MohamedNasser-ASU/4Bit_Signed_ALU/simulation/README.md

# Simulation

This folder contains the Logisim Evolution simulation files for the 4-bit signed ALU project.

The simulation is used to test the ALU logic before or alongside the physical breadboard build. It includes the main ALU circuit and its subcircuits, such as ADD/SUB, comparator, absolute value logic, and multiplier.

Open the `.circ` file using Logisim Evolution to inspect, run, and test the circuit.

Screenshots of the simulation are stored separately in the `images/Logisim/` folder.
