MohamedNasser-ASU/4Bit_Signed_ALU/images/TinkerCAD/README.md

# TinkerCAD Circuit Screenshots

This directory contains screenshots of the TinkerCAD breadboard-style simulations for the 4-bit signed ALU project.

## Files

- `A&B_inputs.png`  
  Shows the DIP switch input section used to provide the 4-bit `A` and `B` values.

- `2's_complementer.png`  
  Shows the two's complement / absolute value circuit used for signed-number handling.

- `Adder_Subtractor.png`  
  Shows the ADD/SUB circuit, where `SUB = 0` performs addition and `SUB = 1` performs subtraction.

- `Comparator.png`  
  Shows the comparator section used to produce greater-than, equal, and less-than outputs.

- `Multiplier.png`  
  Shows the multiplier section used to generate the product output.

- `Full_ALU.png`  
  Shows the complete TinkerCAD ALU simulation with the main modules connected together.

## Note

These screenshots document the TinkerCAD simulation stage of the project before or alongside the physical breadboard implementation.
