MohamedNasser-ASU/4Bit_Signed_ALU/Documentation/Block diagrams/2sComplementer.jpeg

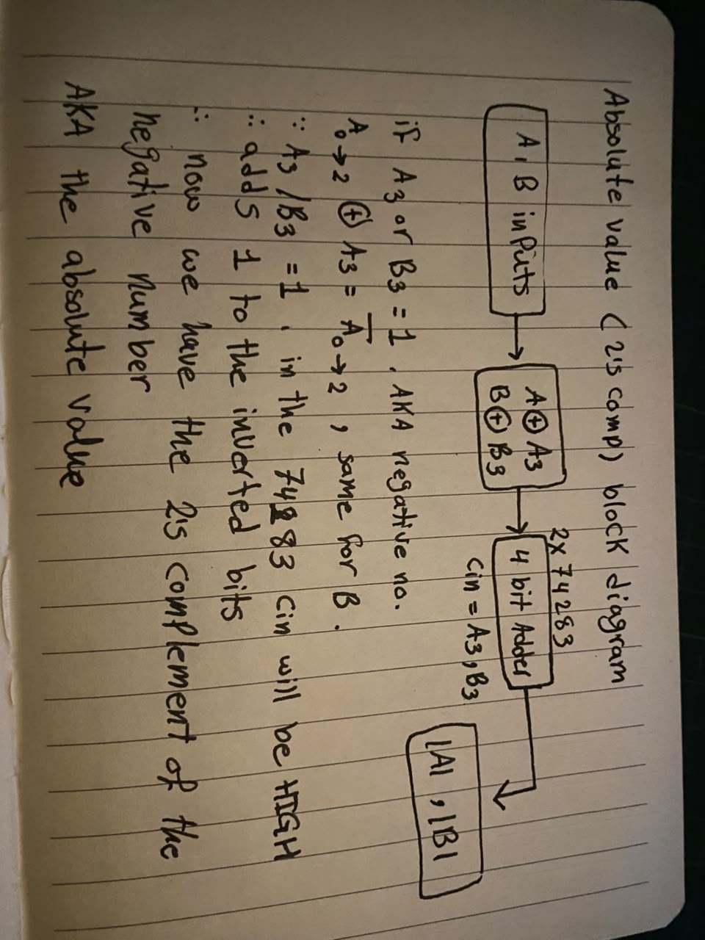
Documentation/Block diagrams/2sComplementer.jpeg
