MohamedNasser-ASU/4Bit_Signed_ALU/Documentation/Block diagrams/ADDSUB.jpeg

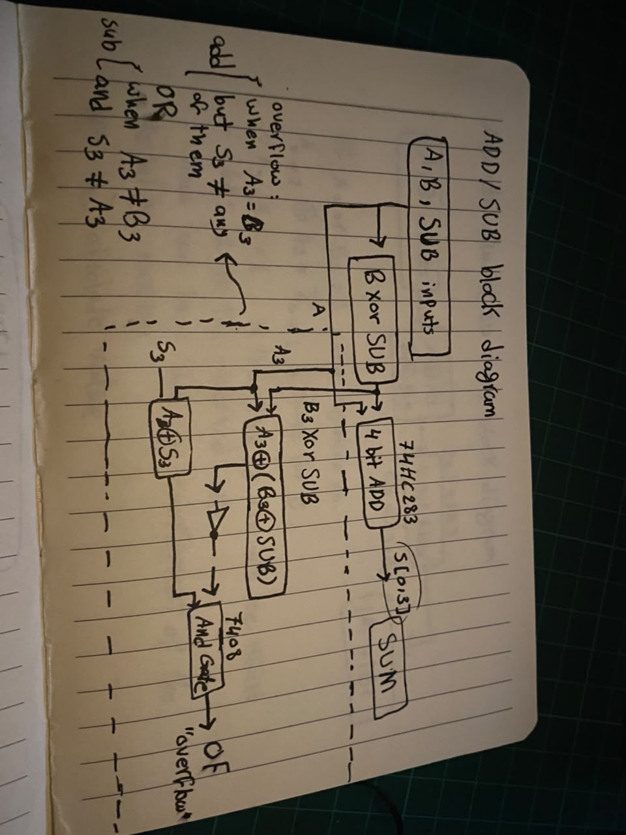
Documentation/Block diagrams/ADDSUB.jpeg
