MohamedNasser-ASU/4Bit_Signed_ALU/Documentation/Block diagrams/Comparator.jpeg

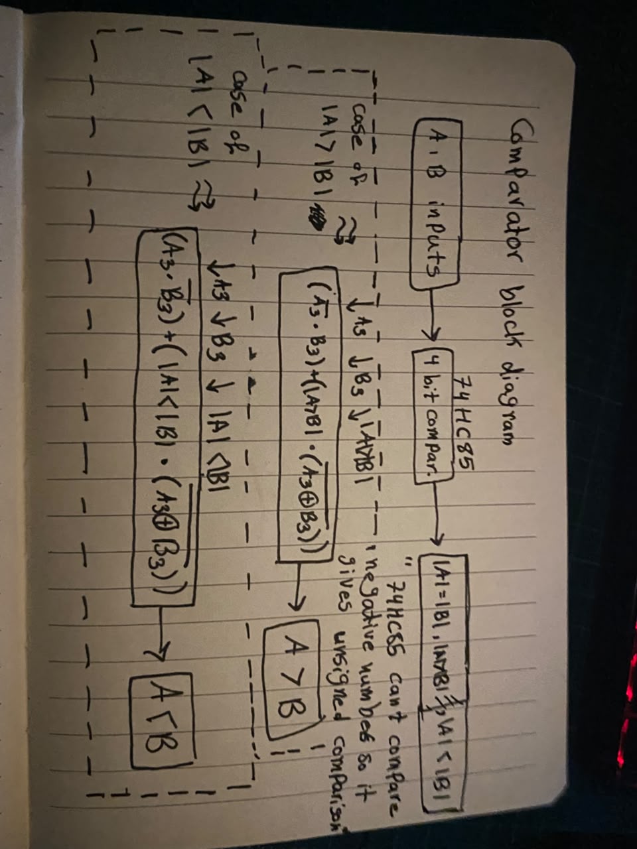
Documentation/Block diagrams/Comparator.jpeg
