MohamedNasser-ASU/4Bit_Signed_ALU/Documentation/Block diagrams/Entire_ALU.jpeg

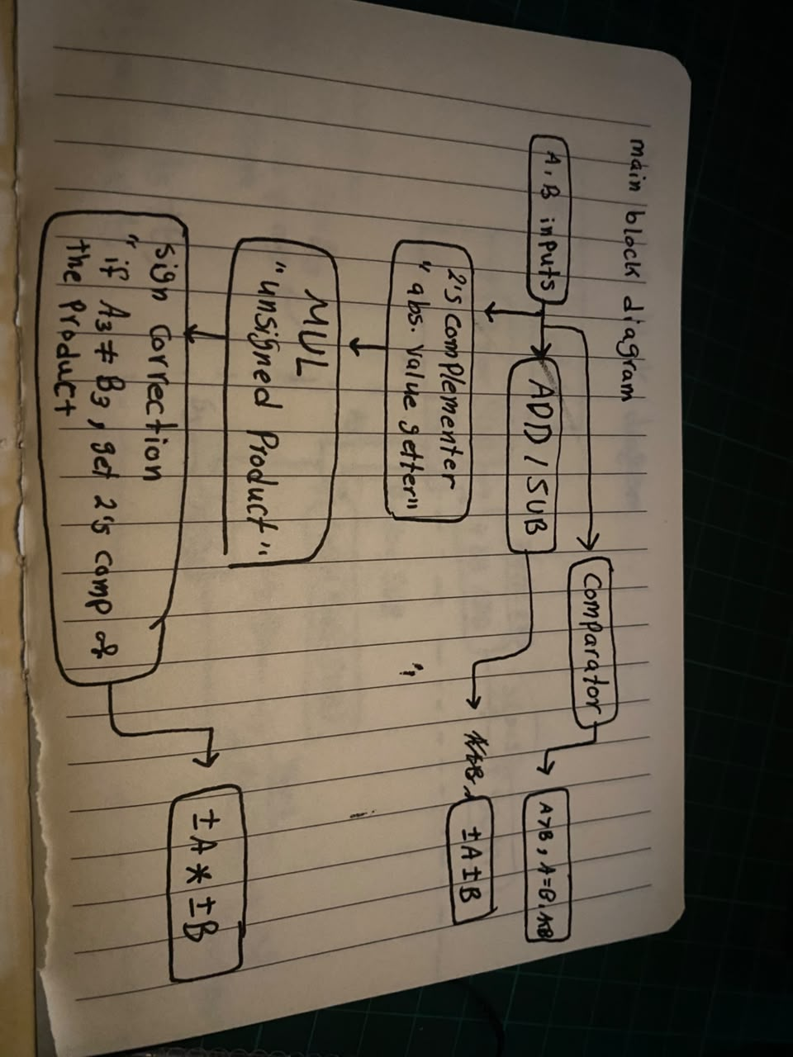
Documentation/Block diagrams/Entire_ALU.jpeg
