MohamedNasser-ASU/4Bit_Signed_ALU/Documentation/Block diagrams/Multiplier.jpeg

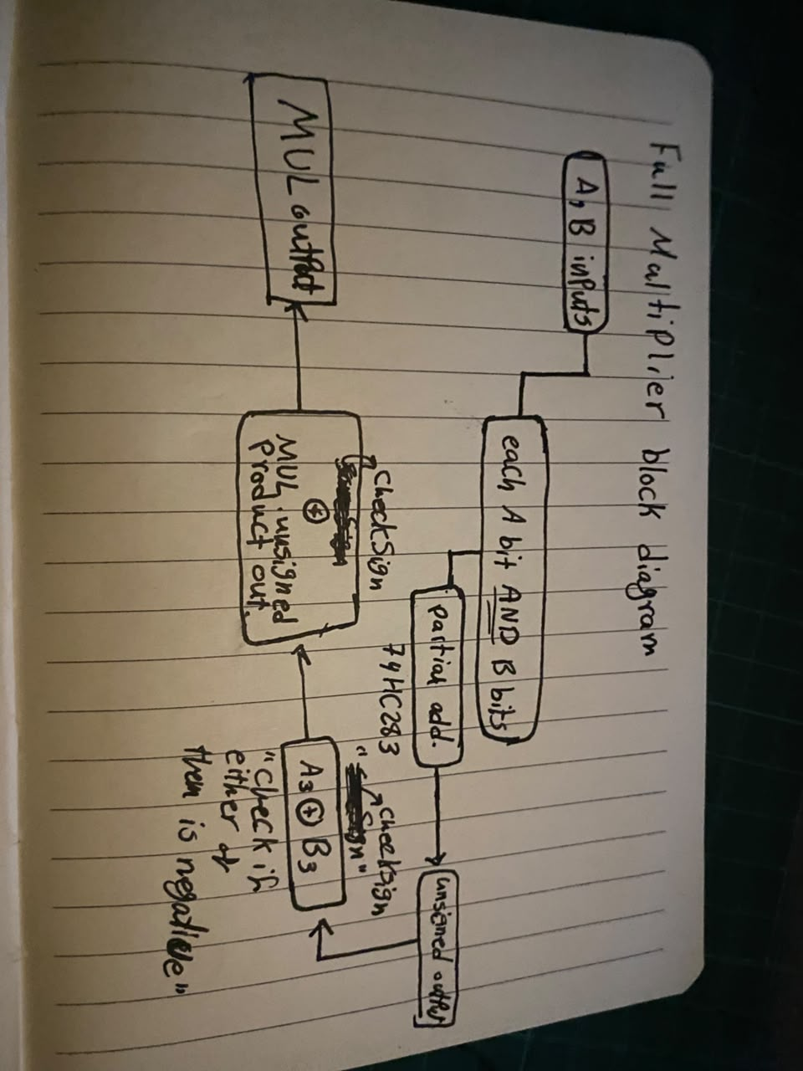
Documentation/Block diagrams/Multiplier.jpeg
