MohamedNasser-ASU/4Bit_Signed_ALU/images/Logisim/ALU_blocks.png

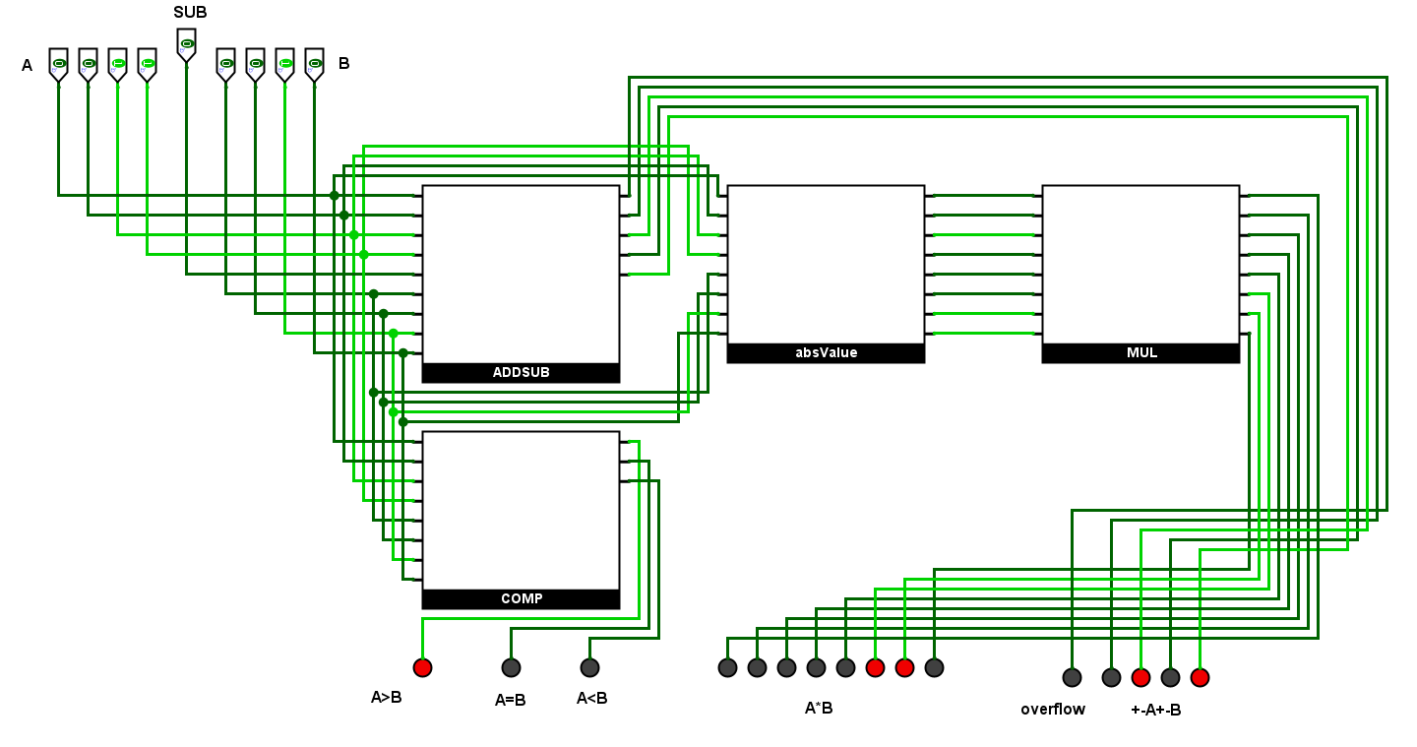
images/Logisim/ALU_blocks.png
