MohamedNasser-ASU/4Bit_Signed_ALU/images/Logisim/ALU_Full.png

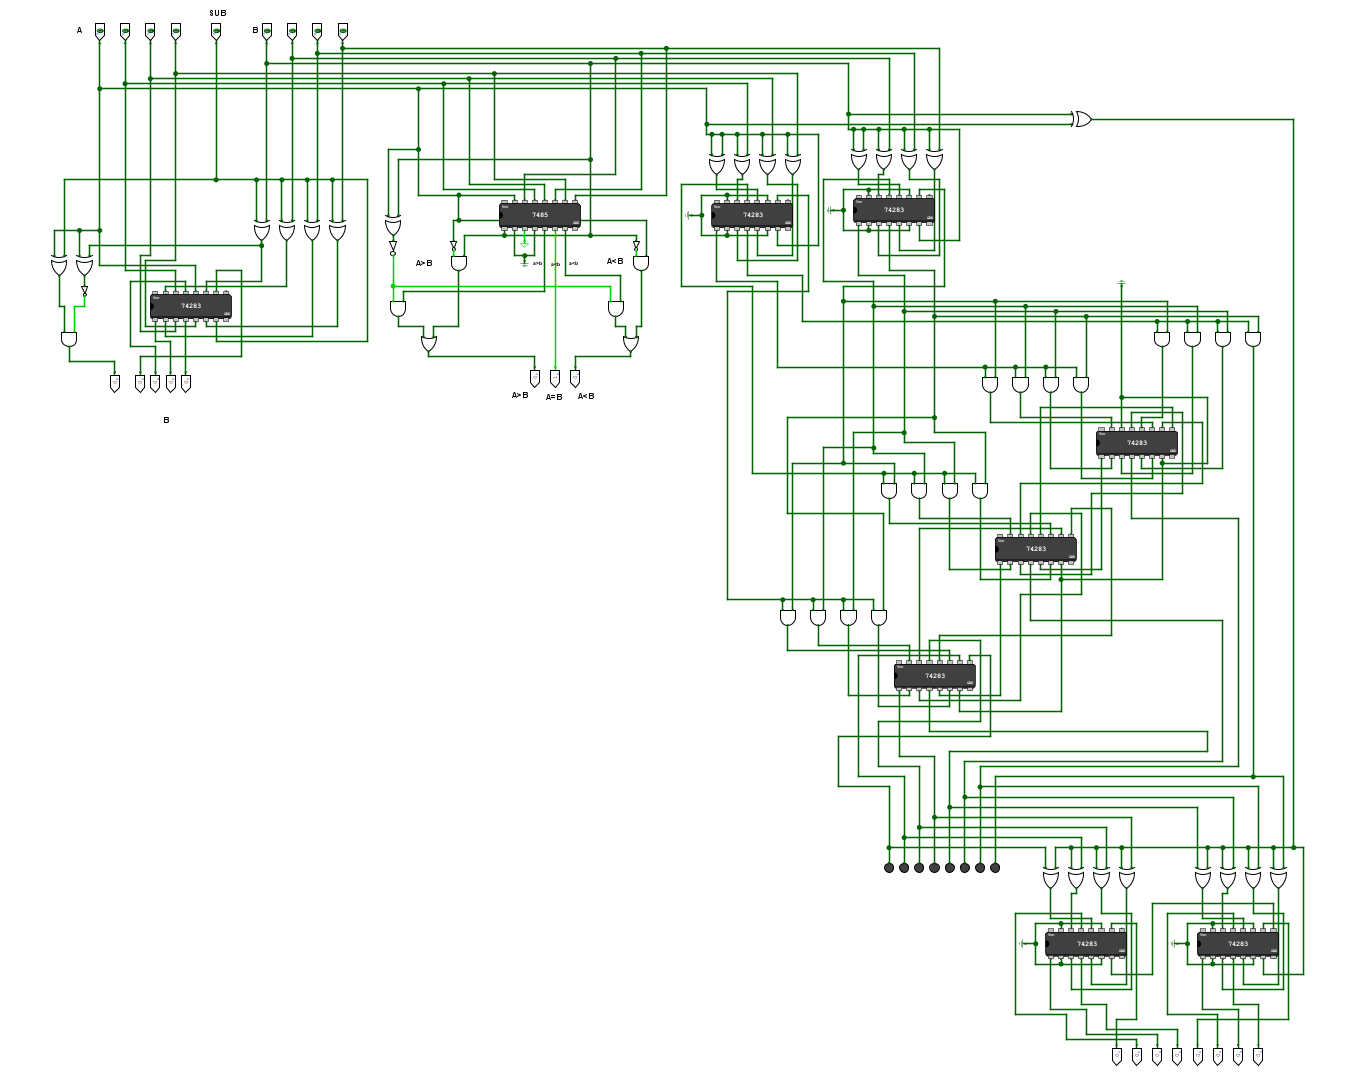
images/Logisim/ALU_Full.png
