MohamedNasser-ASU/4Bit_Signed_ALU/images/Logisim/Logisim_AbsoulteValueGetter_2sComplementer.png

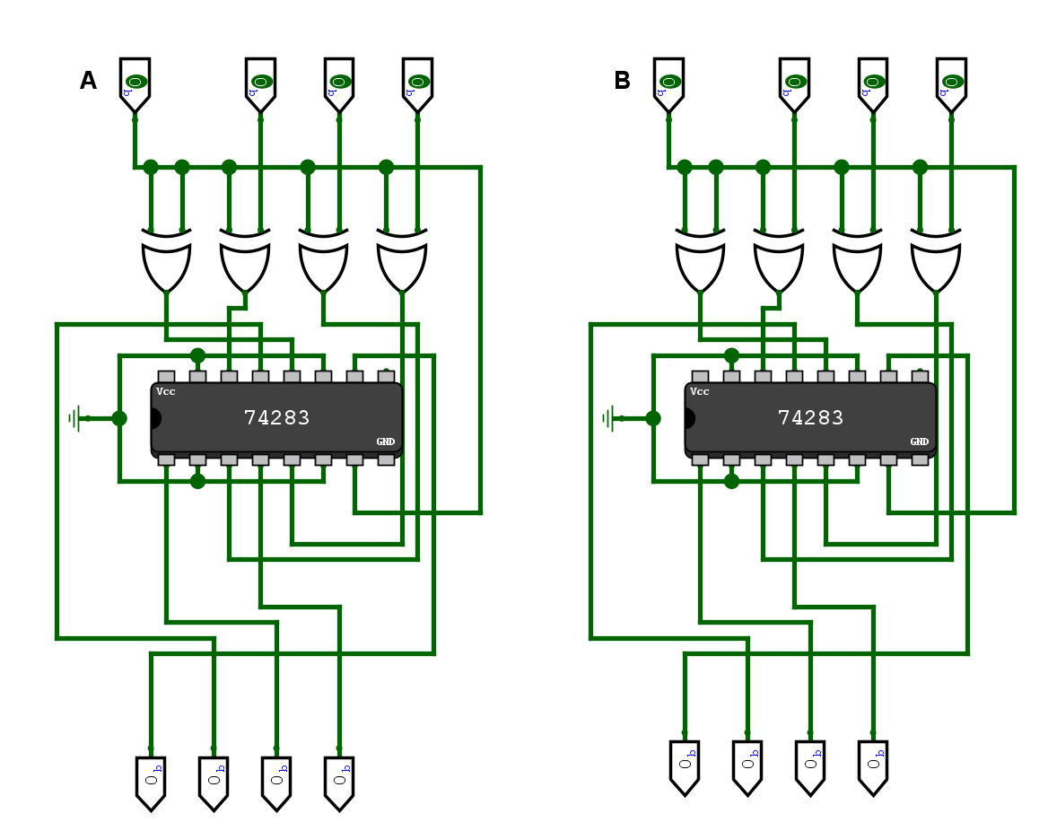
images/Logisim/Logisim_AbsoulteValueGetter_2sComplementer.png
