MohamedNasser-ASU/4Bit_Signed_ALU/images/Logisim/Logisim_ADD_SUB.png

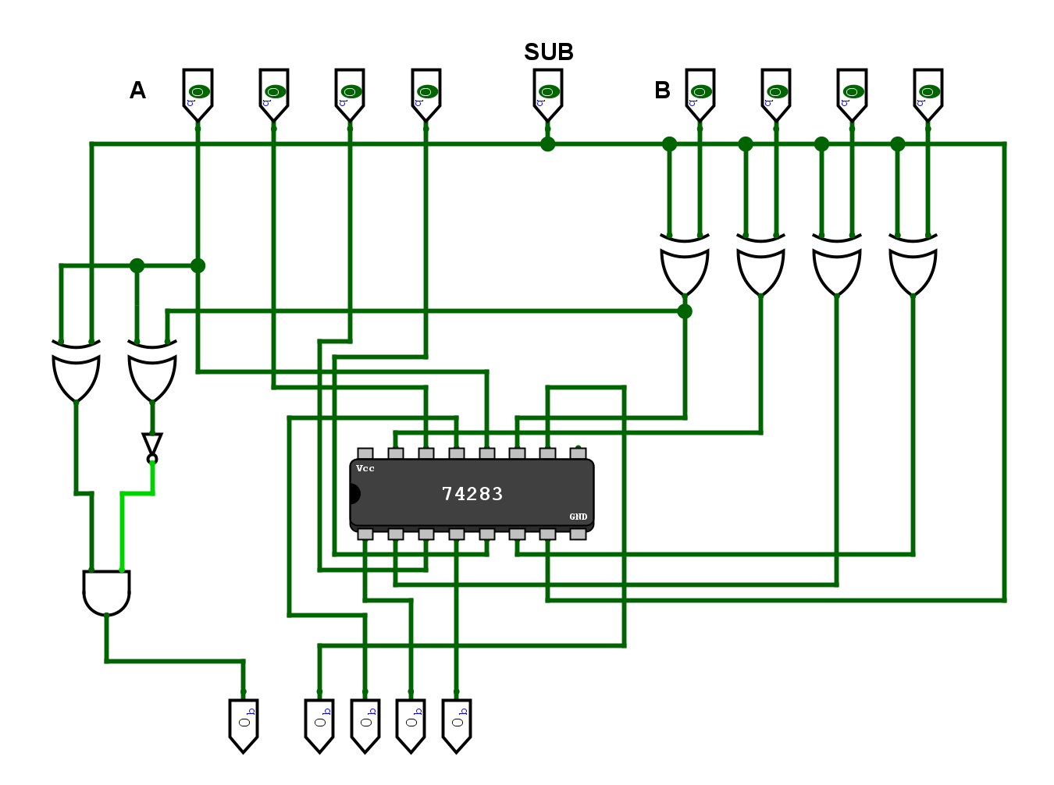
images/Logisim/Logisim_ADD_SUB.png
