MohamedNasser-ASU/4Bit_Signed_ALU/images/Logisim/Logisim_Comparator.png

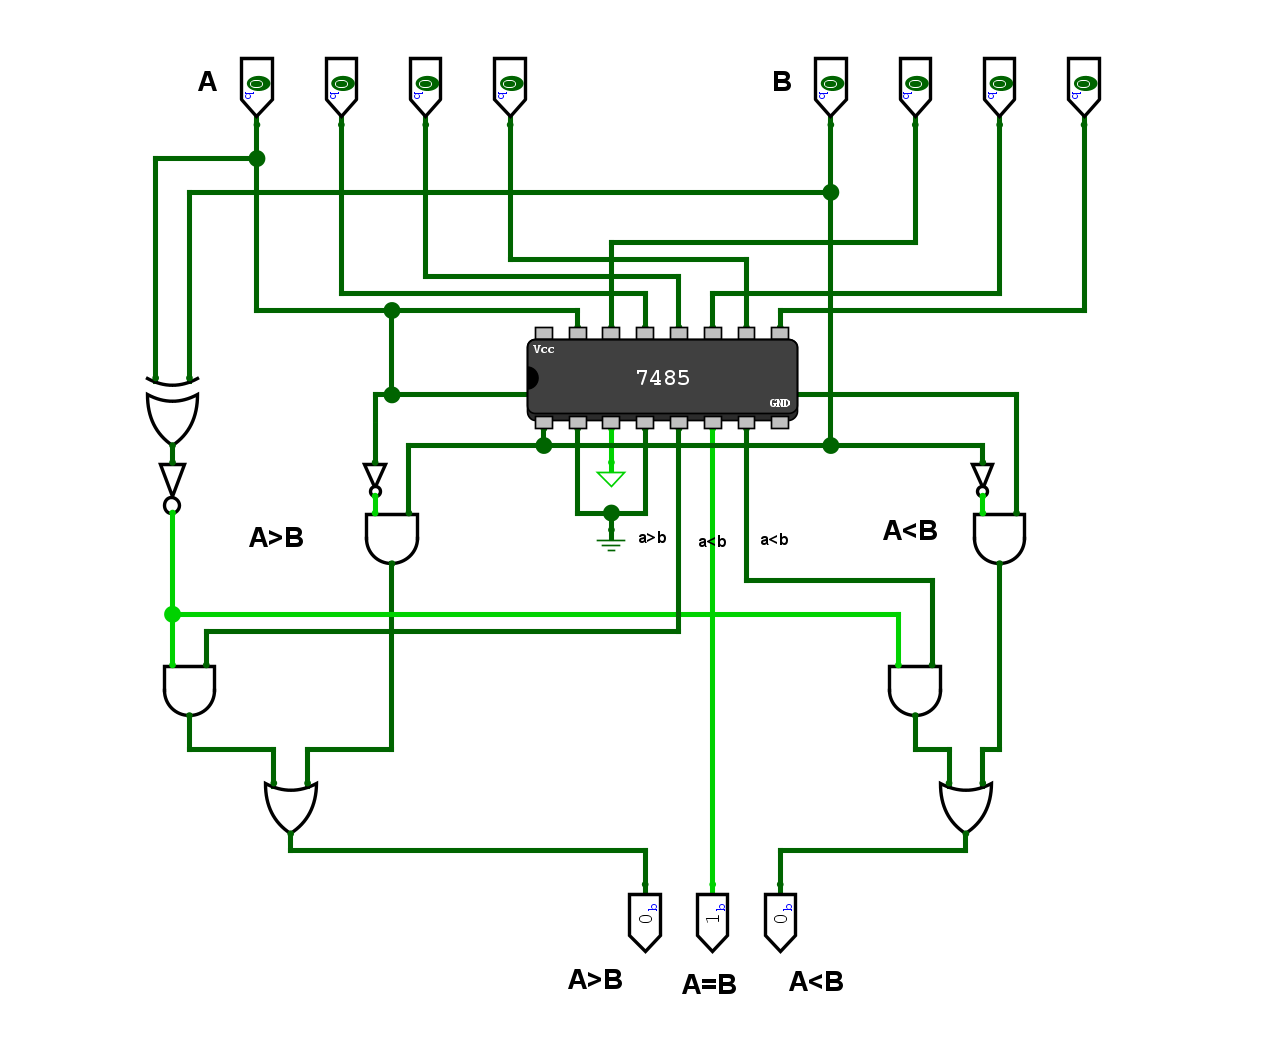
images/Logisim/Logisim_Comparator.png
