MohamedNasser-ASU/4Bit_Signed_ALU/images/Logisim/Logisim_Multiplier.png

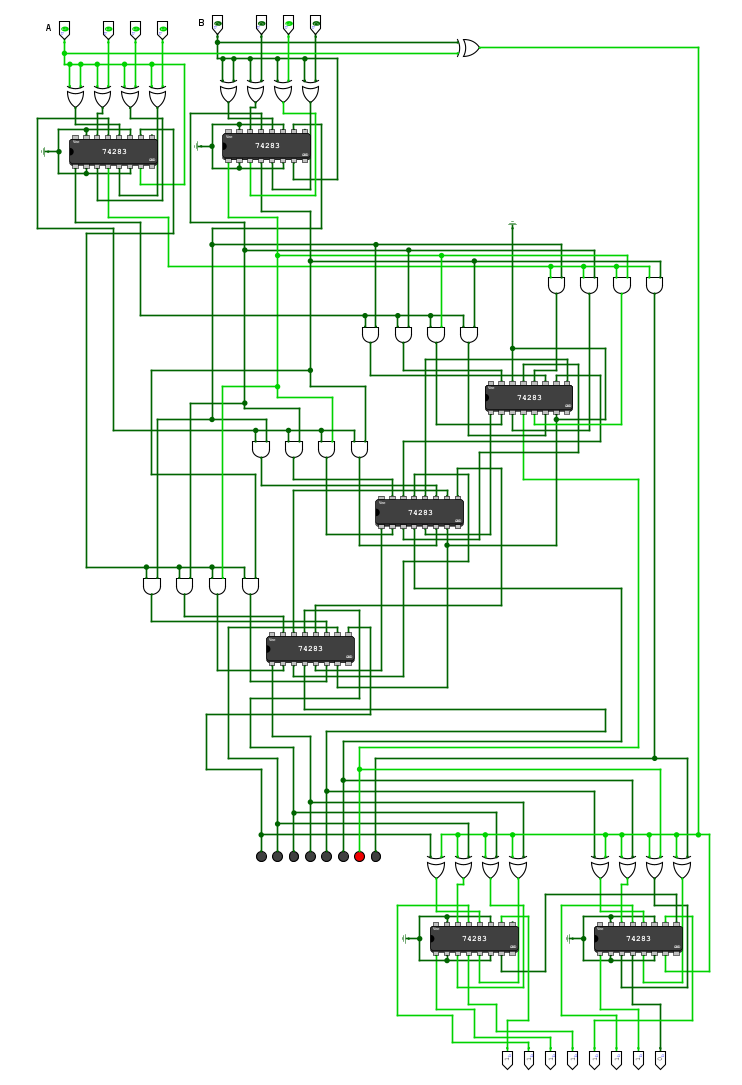
images/Logisim/Logisim_Multiplier.png
