MohamedNasser-ASU/4Bit_Signed_ALU/images/TinkerCAD/2's_complementer.png

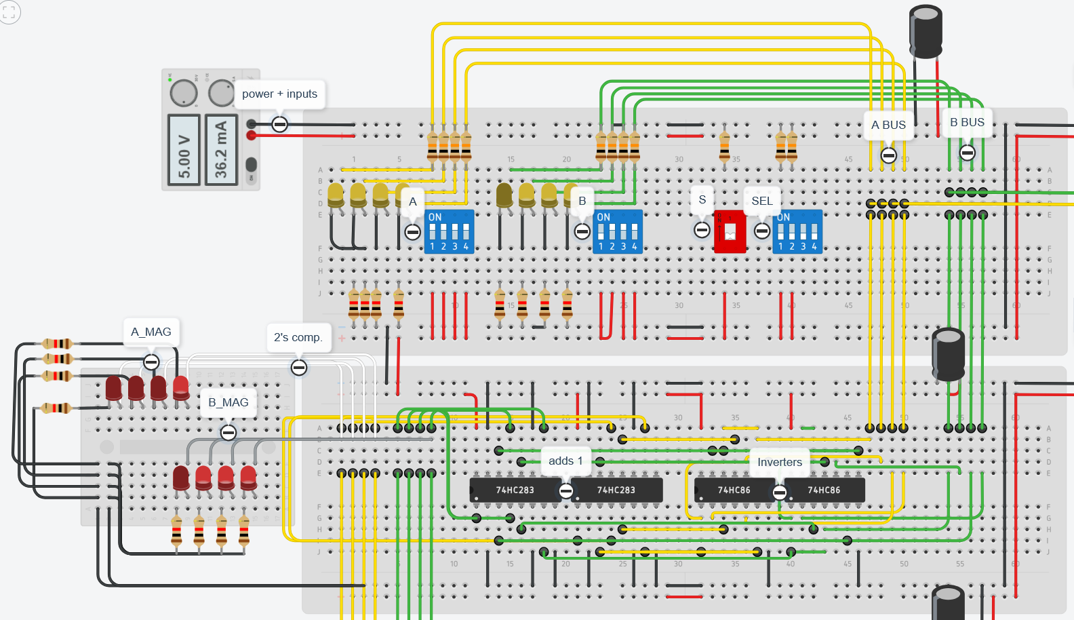
images/TinkerCAD/2's_complementer.png
