MohamedNasser-ASU/4Bit_Signed_ALU/images/TinkerCAD/A&B_inputs.png

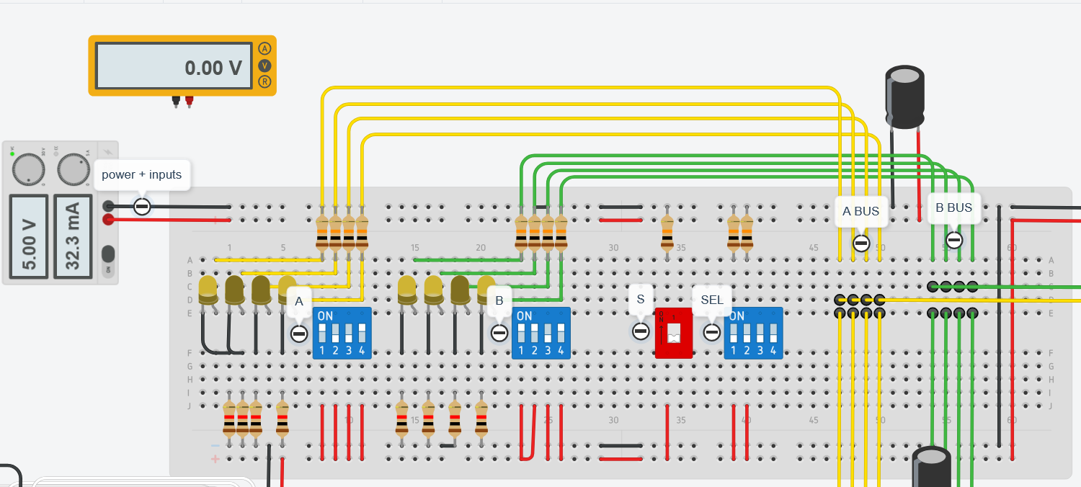
images/TinkerCAD/A&B_inputs.png
