MohamedNasser-ASU/4Bit_Signed_ALU/images/TinkerCAD/Adder_Subtractor.png

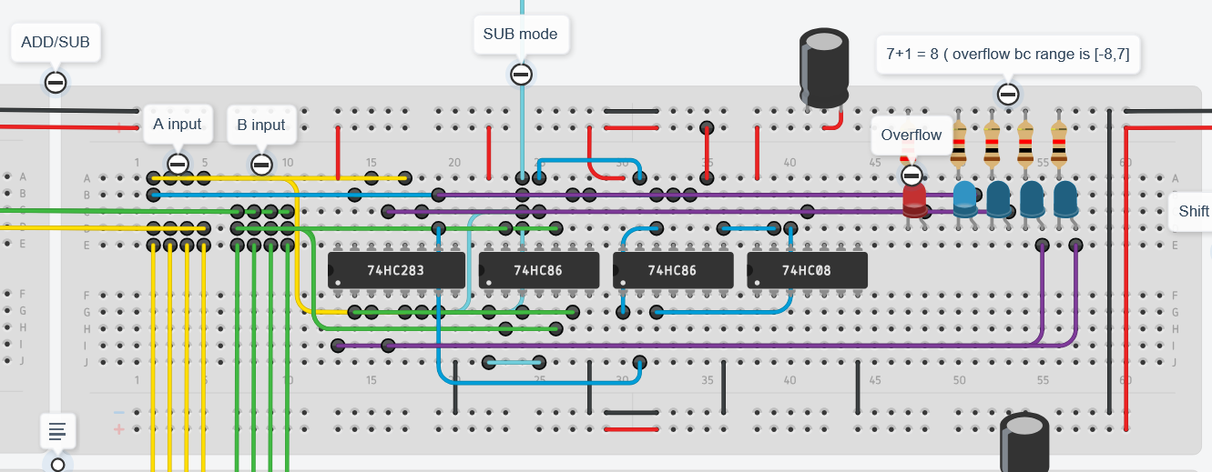
images/TinkerCAD/Adder_Subtractor.png
