MohamedNasser-ASU/4Bit_Signed_ALU/images/TinkerCAD/Comparator.png

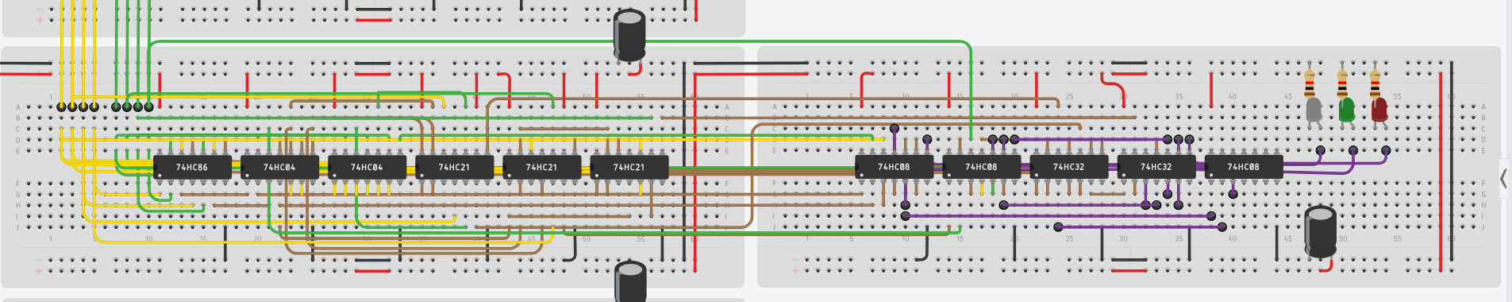
images/TinkerCAD/Comparator.png
