MohamedNasser-ASU/4Bit_Signed_ALU/images/TinkerCAD/Full_ALU.png

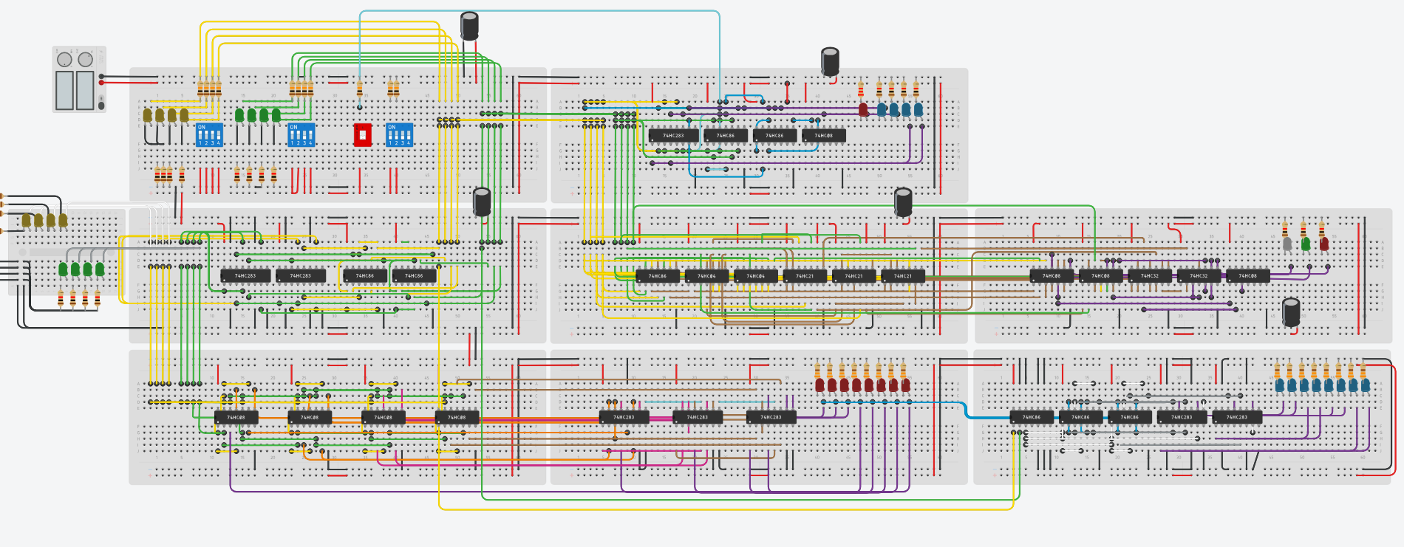
images/TinkerCAD/Full_ALU.png
