MohamedNasser-ASU/4Bit_Signed_ALU/images/TinkerCAD/Multiplier.png

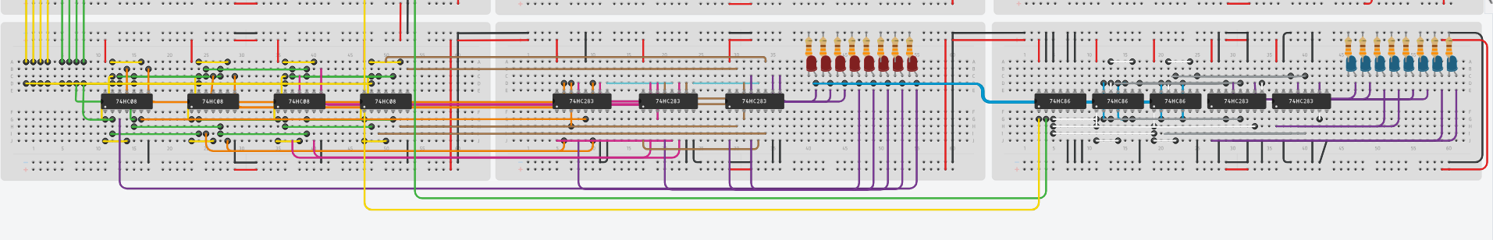
images/TinkerCAD/Multiplier.png
