MohamedNasser-ASU/4Bit_Signed_ALU/Testing/TinkerCAD/0000_0000.png

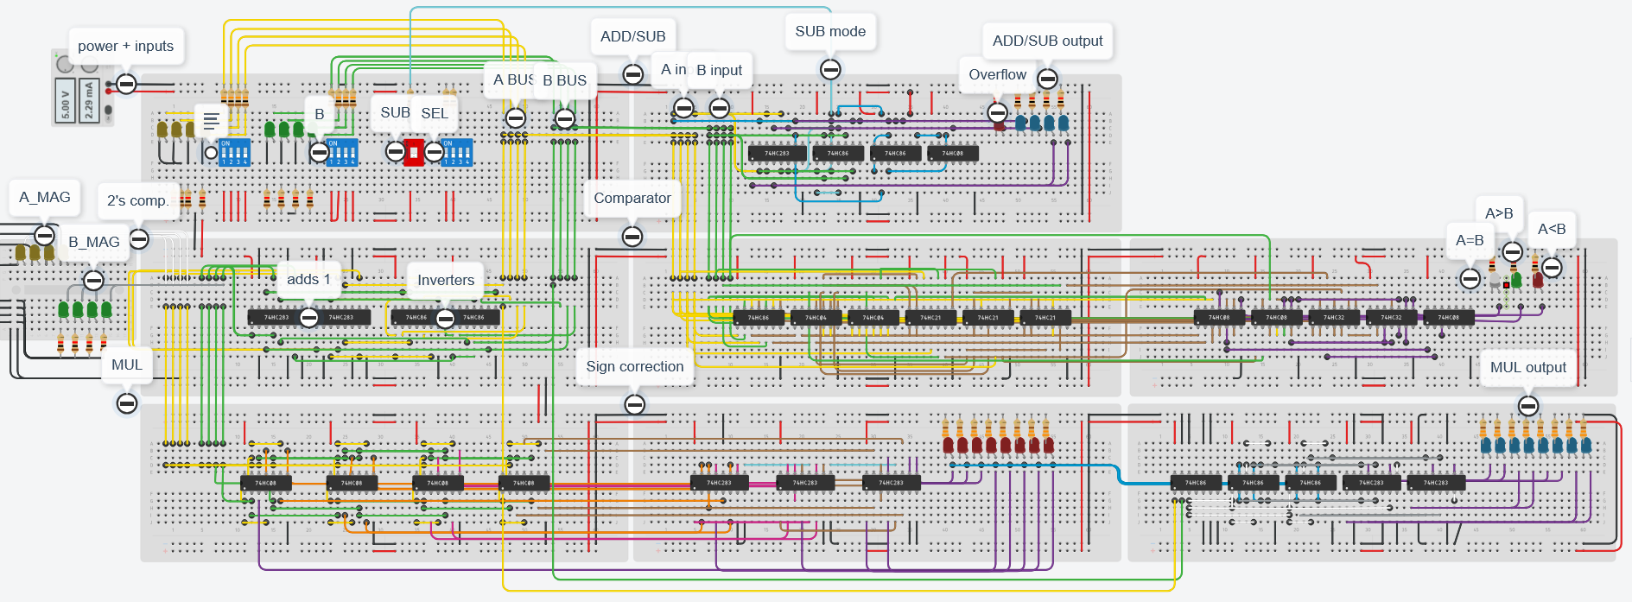
Testing/TinkerCAD/0000_0000.png
