MohamedNasser-ASU/4Bit_Signed_ALU/Testing/TinkerCAD/0001_0001.png

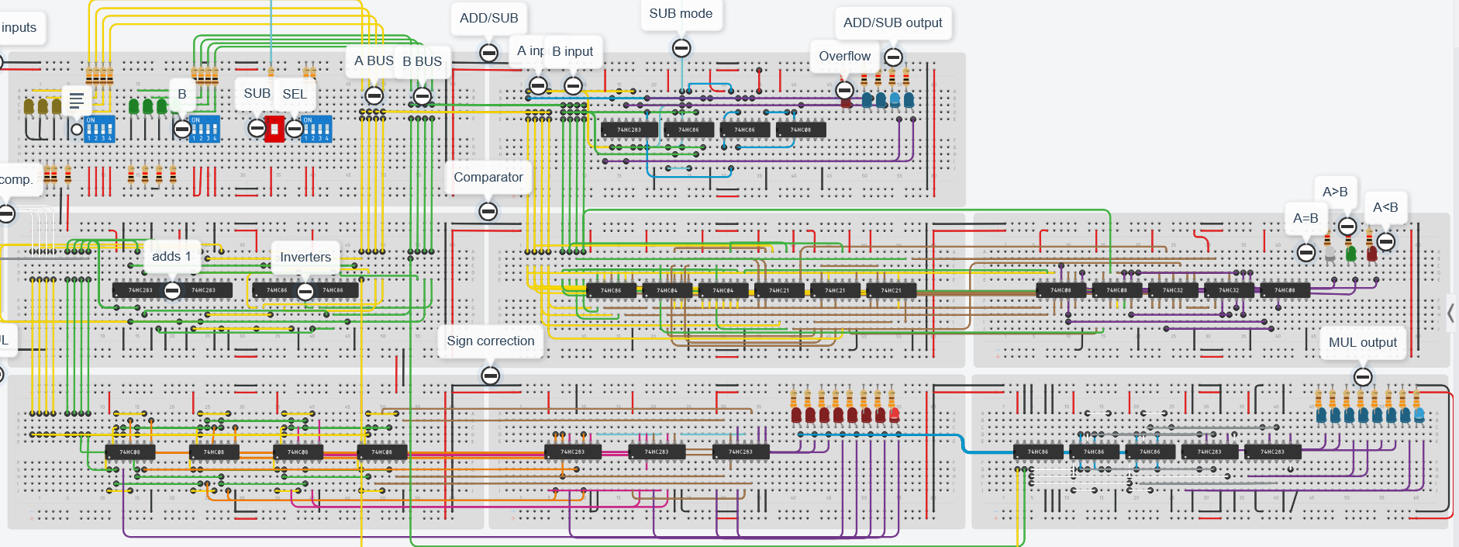
Testing/TinkerCAD/0001_0001.png
