MohamedNasser-ASU/4Bit_Signed_ALU/Testing/TinkerCAD/0011_0010.png

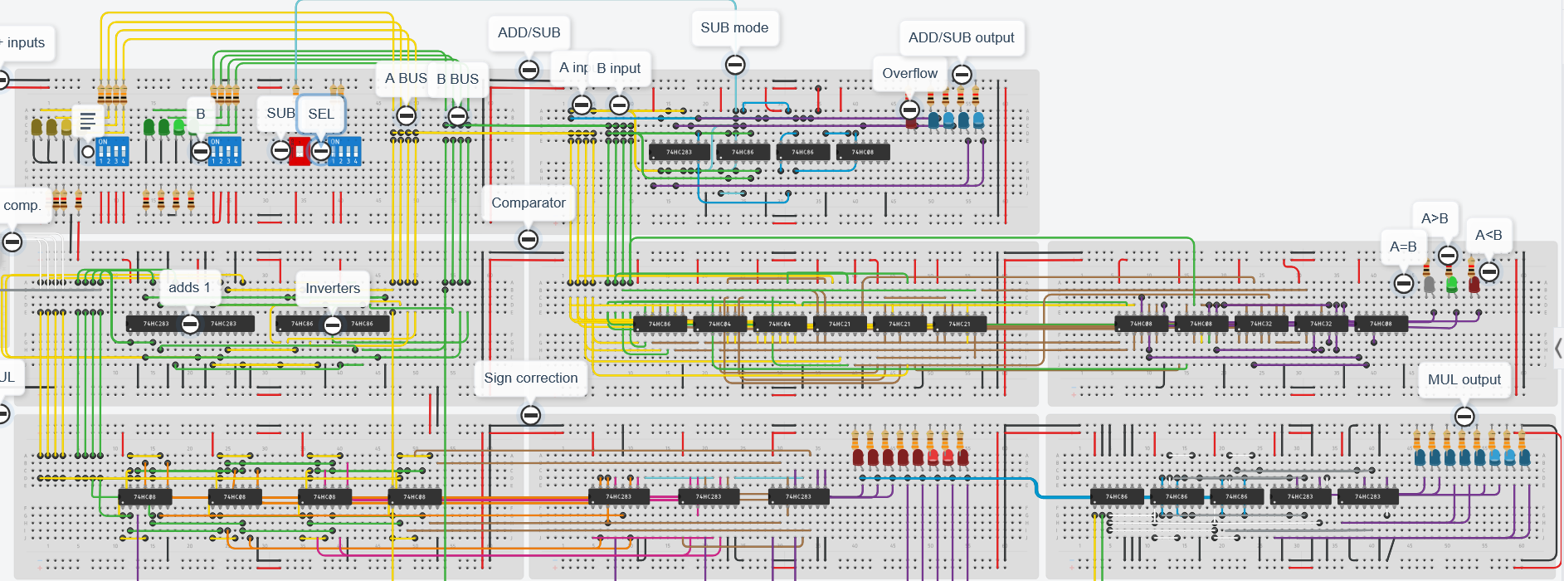
Testing/TinkerCAD/0011_0010.png
