MohamedNasser-ASU/4Bit_Signed_ALU/Testing/TinkerCAD/0111_0110.png

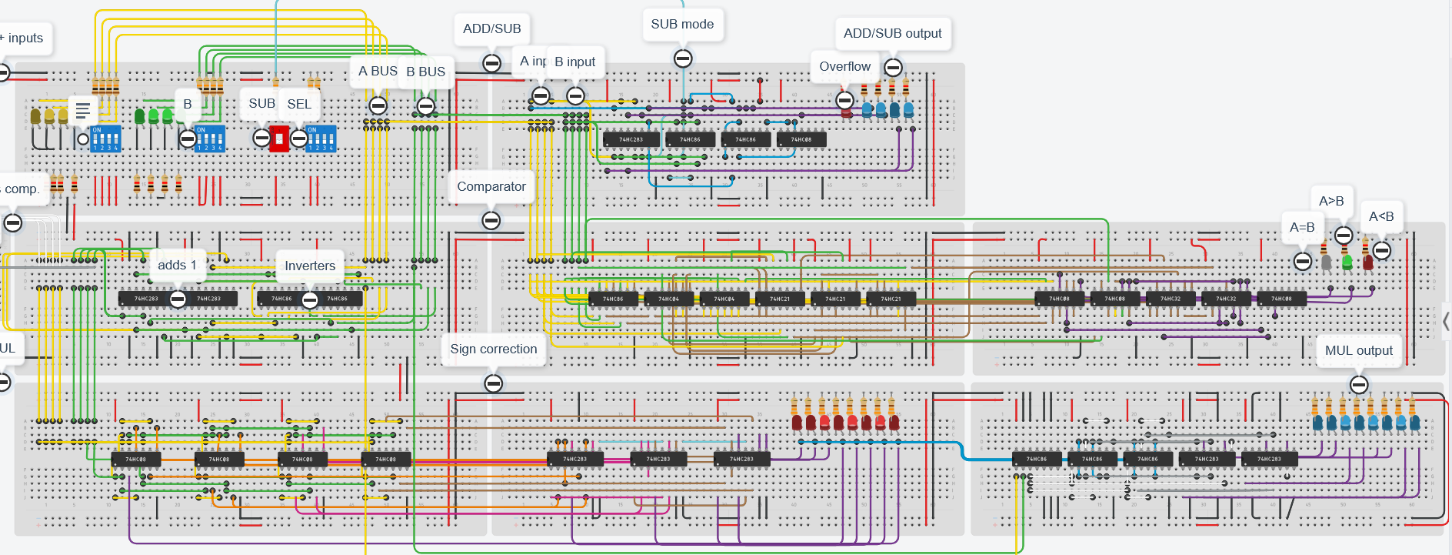
Testing/TinkerCAD/0111_0110.png
