MohamedNasser-ASU/4Bit_Signed_ALU/Testing/TinkerCAD/1000_1000_SUB.png

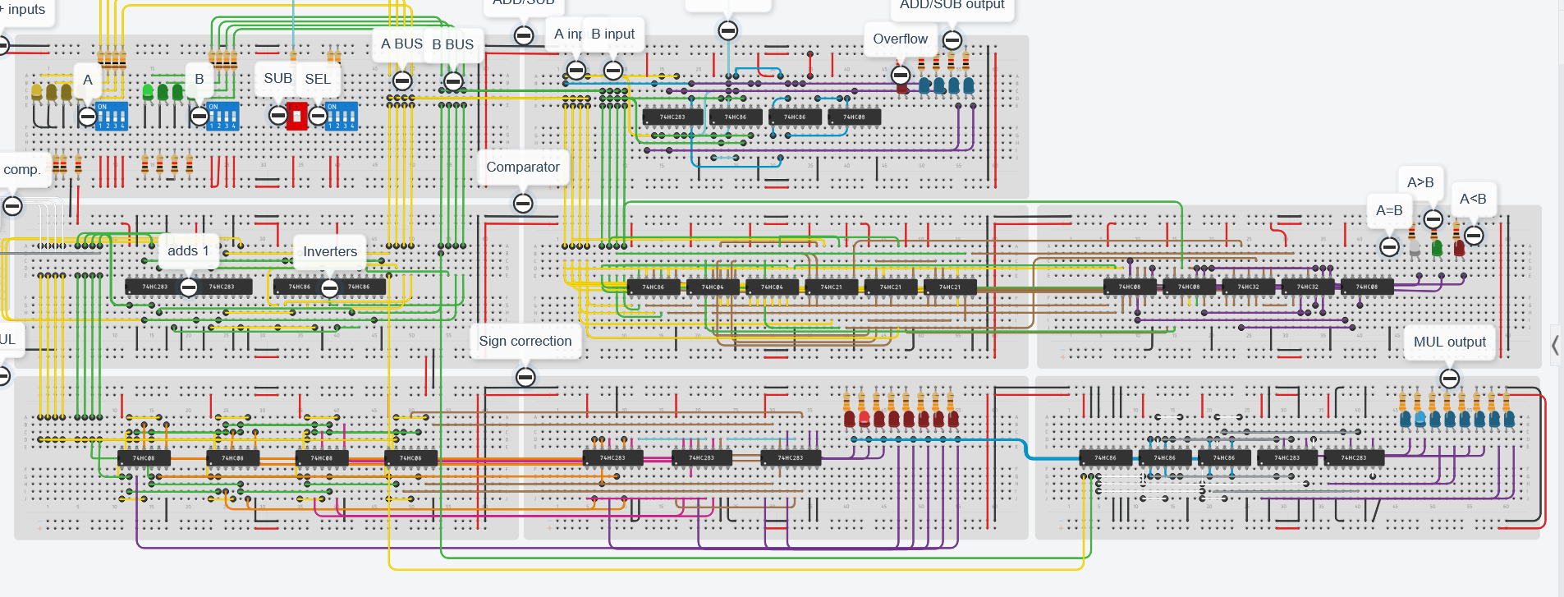
Testing/TinkerCAD/1000_1000_SUB.png
