MohamedNasser-ASU/4Bit_Signed_ALU/Testing/TinkerCAD/1011_1001.png

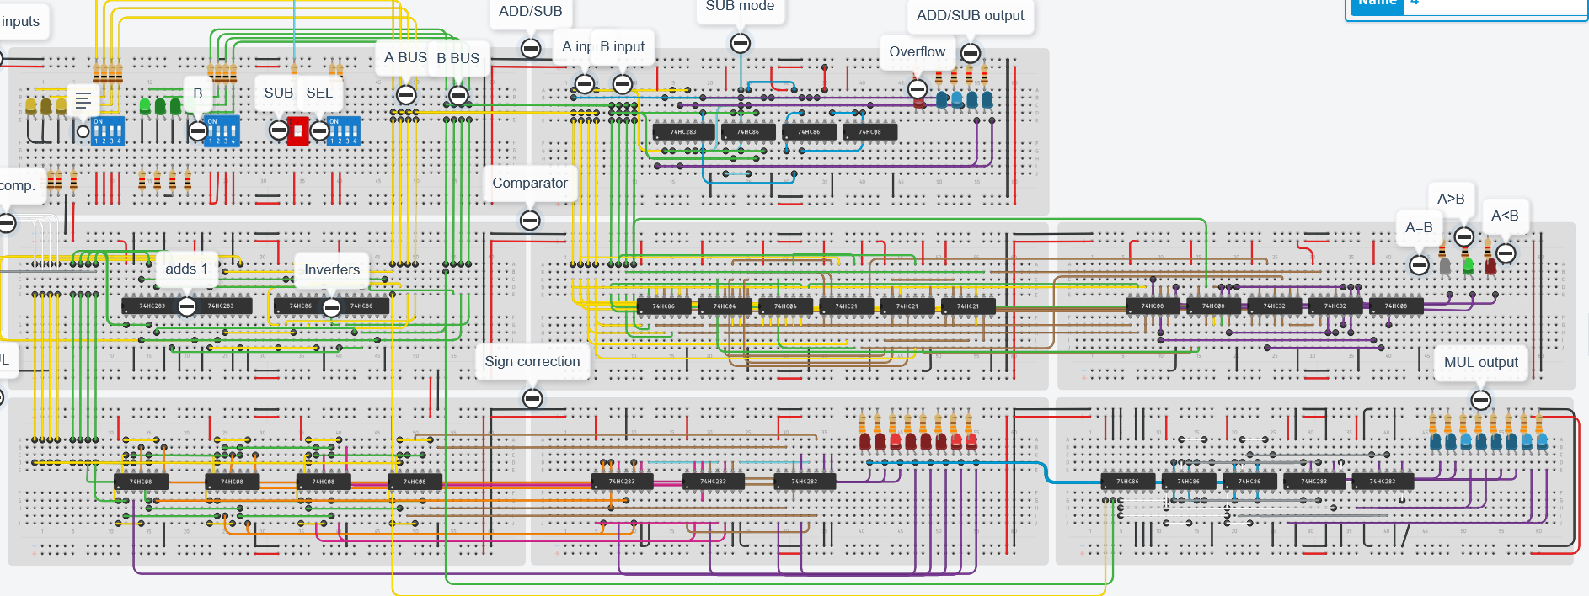
Testing/TinkerCAD/1011_1001.png
