MohamedNasser-ASU/4Bit_Signed_ALU/Testing/TinkerCAD/1111_0111.png

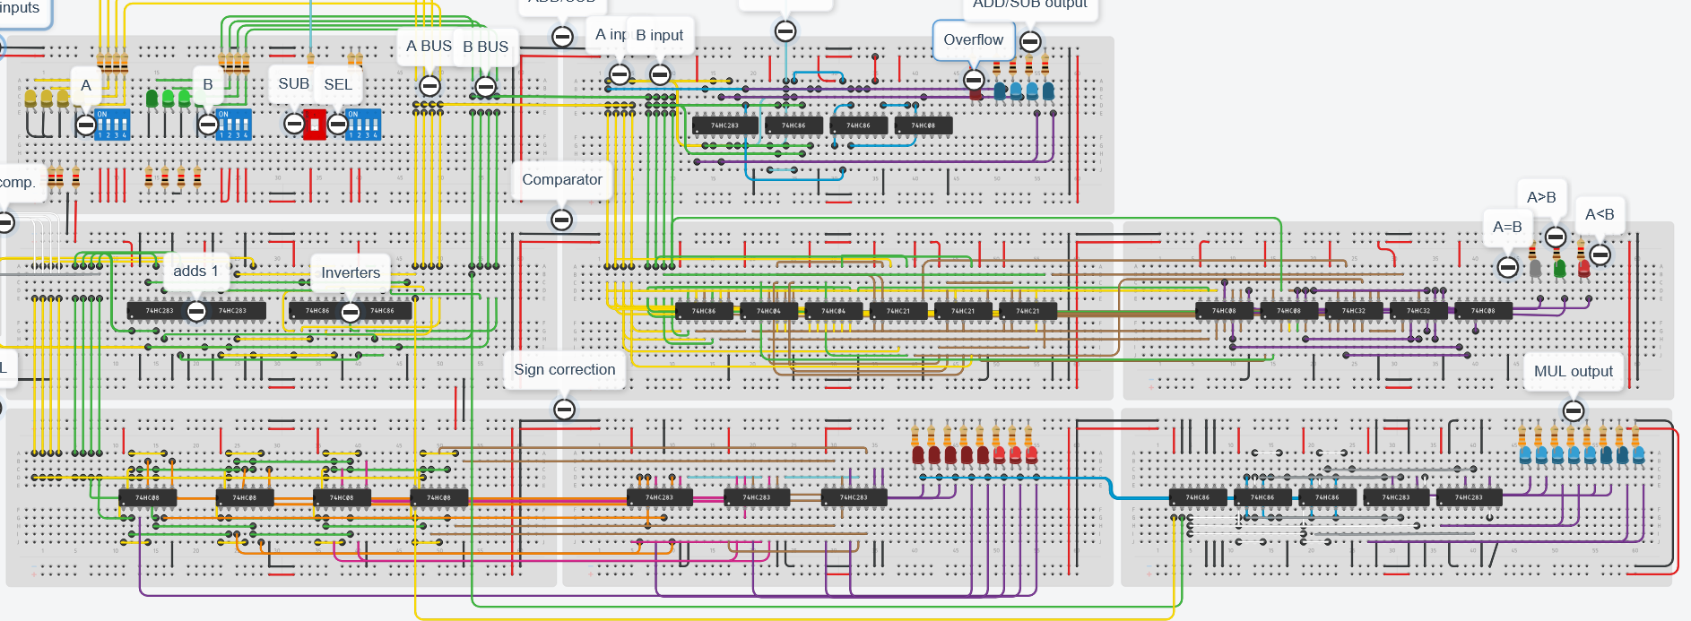
Testing/TinkerCAD/1111_0111.png
