MohamedNasser-ASU/4Bit_Signed_ALU/(list of files, drawings)

Other design files:
simulation/Files/2sComplementer.circ
simulation/Files/ADDSUB.circ
simulation/Files/ALU.circ
simulation/Files/Comparator.circ
simulation/Files/Multiplier.circ
