MohamedNasser-ASU/4Bit_Signed_ALU/(commit log)

2026-06-22 uploaded 2's complement TinkerCAD circuit
2026-06-22 Rename components folder to circuits
2026-06-24 uploaded comparison circuit
2026-07-04 Add README for TinkerCAD circuit screenshots
    This README provides an overview of TinkerCAD circuit screenshots for the 4-bit signed ALU project, detailing the purpose of each image.
2026-07-04 Upload full ALU .circ
    [ALU.circ]
2026-07-04 Upload 2sComp .circ
    [2sComplementer.circ]
2026-07-04 Upload Adder subtractor
    [ADDSUB.circ]
2026-07-04 Add components list for 4-bit signed ALU project
    This document lists the main components used in the 4-bit signed ALU project, including logic ICs, control components, display components, resistors, capacitors, and power sources.
2026-07-04 Add wiring notes for 4-bit signed ALU implementation
    This file contains practical wiring notes for the physical implementation of a 4-bit signed ALU, including power rules, capacitor usage, DIP switch inputs, LED wiring, and debugging advice.
2026-07-06 Update README with test case details for ALU project
    Added detailed information about test cases for the 4-bit signed ALU project, including folder structure and purpose.
2026-07-16 Implement 4-Bit Signed ALU Display with LCD
    This code implements a 4-bit signed ALU display using an Arduino Nano with shift registers and an LCD. It handles addition, subtraction, comparison, and multiplication operations, displaying results on the LCD.
